IMI-eRnD-Be/SWD-Adapter/(commit log)

2025-09-05 Adding files
    [JtagArm20Adapter-B_Cu.gbr, JtagArm20Adapter-B_Mask.gbr, JtagArm20Adapter-B_Silkscreen.gbr, JtagArm20Adapter-Edge_Cuts.gbr, JtagArm20Adapter-F_Cu.gbr, JtagArm20Adapter-F_Mask.gbr, JtagArm20Adapter-F_Silkscreen.gbr, JtagArm20Adapter-NPTH.drl]
2025-09-05 deleting files to apply gitignore
    [JtagArm20Adapter-B_Cu.gbr, JtagArm20Adapter-B_Mask.gbr, JtagArm20Adapter-B_Silkscreen.gbr, JtagArm20Adapter-Edge_Cuts.gbr, JtagArm20Adapter-F_Cu.gbr, JtagArm20Adapter-F_Mask.gbr, JtagArm20Adapter-F_Silkscreen.gbr, JtagArm20Adapter-NPTH.drl]
2025-09-05 moving solder bridges to top layer
    [JtagArm20Adapter.kicad_pcb]
2025-09-05 deleting solder bridges
    [JtagArm20Adapter.kicad_pcb, JtagArm20Adapter.kicad_sch]
2025-09-05 moving J4
    [JtagArm20Adapter.kicad_pcb]
2025-09-08 Adapt to Eurocircuits manufacturability
    [JtagArm20Adapter.kicad_pcb]
